tdorssers/Robot/schematic/Robot.sch

## EAGLE design schematic/Robot.sch (2018-08-26)

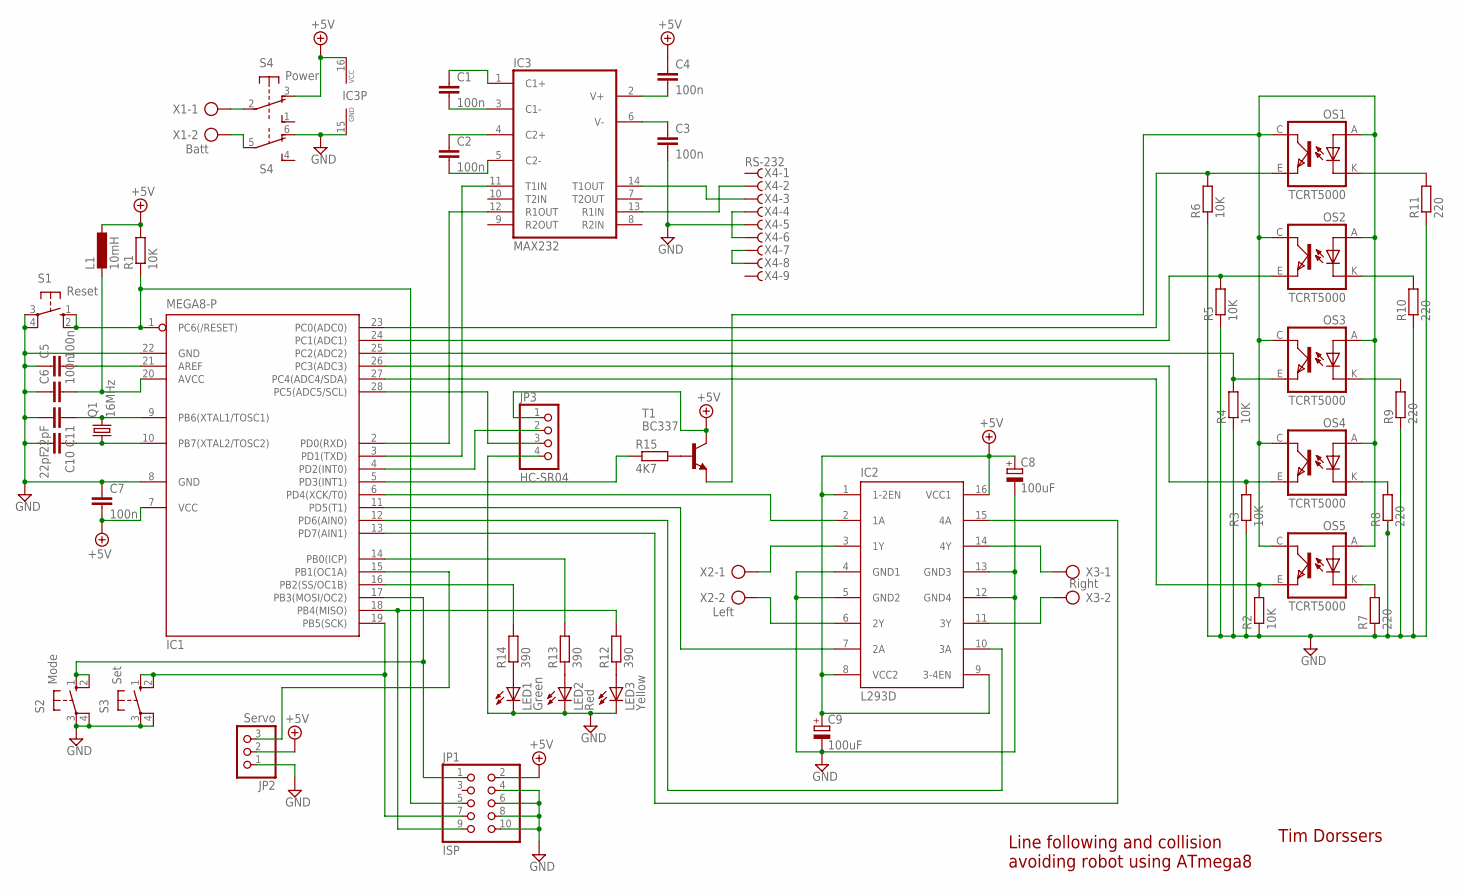
[picture p3: schematic Robot.sch]

Parts:
C1, C2, C3, C4, C5, C6, C7: 100n; C025-025X050
C8, C9: 100uF; B45181A
C10, C11: 22pF; C025-024X044
IC1: MEGA8-P; DIL28-3
IC2: L293D; DIL16
IC3: MAX232; DIL16
JP1: ISP; 2X05
JP2: Servo; 1X03
JP3: HC-SR04; 1X04
L1: 10mH; 0207/10
LED1: Green; LED5MM
LED2: Red; LED5MM
LED3: Yellow; LED5MM
OS1, OS2, OS3, OS4, OS5: TCRT5000
Q1: 16MHz; HC49U-V
R1, R2, R3, R4, R5, R6: 10K; 0204/7
R7, R8, R9, R10, R11: 220; 0204/7
R12, R13, R14: 390; 0204/7
R15: 4K7; 0204/7
S1: Reset; B3F-10XX
S2: Mode; B3F-10XX
S3: Set; B3F-10XX
S4: Power; PVA2F
T1: BC337; TO92
X1: Batt; AK300/2
X2: Left; AK300/2
X3: Right; AK300/2
X4: RS-232; H3M09RA

Connections:
+5V: C4.1, C7.2, C8.+, C9.+, IC1.7 (VCC), IC2.1 (1-2EN), IC2.8 (VCC2), IC2.9 (3-4EN), IC2.16 (VCC1), IC3.16 (VCC), JP1.2, JP2.2, JP3.1, L1.1, R1.2, S4.3 (O), T1.3 (C)
GND: C3.2, C5.1, C6.1, C7.1, C8.-, C9.-, C10.2, C11.2, IC1.8 (GND), IC1.22 (GND), IC2.4 (GND1), IC2.5 (GND2), IC2.12 (GND4), IC2.13 (GND3), IC3.15 (GND), JP1.4, JP1.6, JP1.8, JP1.10, JP2.1, JP3.4, LED1.K (C), LED2.K (C), LED3.K (C), R2.1, R3.1, R4.1, R5.1, R6.1, R7.1, R8.1, R9.1, R10.1, R11.1, S1.3, S1.4 (P1), S2.3, S2.4 (P1), S3.3, S3.4 (P1), S4.6 (O), X4.5
unnamed: LED3.A, R12.1
unnamed: IC1.23 (PC0(ADC0)), OS1.E (EMITTER), R6.2
unnamed: IC1.24 (PC1(ADC1)), OS2.E (EMITTER), R5.2
unnamed: IC1.25 (PC2(ADC2)), OS3.E (EMITTER), R4.2
unnamed: IC1.26 (PC3(ADC3)), OS4.E (EMITTER), R3.2
unnamed: IC1.27 (PC4(ADC4/SDA)), OS5.E (EMITTER), R2.2
unnamed: OS5.K (CATHODE), R7.2
unnamed: OS1.K (CATHODE), R11.2
unnamed: OS2.K (CATHODE), R10.2
unnamed: OS3.K (CATHODE), R9.2
unnamed: OS4.K (CATHODE), R8.2
unnamed: S4.5, X1.2
unnamed: C4.2, IC3.2 (V+)
unnamed: C3.1, IC3.6 (V-)
unnamed: C1.1, IC3.1 (C1+)
unnamed: C1.2, IC3.3 (C1-)
unnamed: C2.1, IC3.4 (C2+)
unnamed: C2.2, IC3.5 (C2-)
unnamed: IC1.1 (PC6(/RESET)), JP1.5, R1.1, S1.1 (S), S1.2 (S1)
unnamed: C11.1, IC1.9 (PB6(XTAL1/TOSC1)), Q1.2
unnamed: C10.1, IC1.10 (PB7(XTAL2/TOSC2)), Q1.1
unnamed: C5.2, IC1.21 (AREF)
unnamed: C6.2, IC1.20 (AVCC), L1.2
unnamed: S4.2, X1.1
unnamed: IC1.2 (PD0(RXD)), IC3.12 (R1OUT)
unnamed: IC1.3 (PD1(TXD)), IC3.11 (T1IN)
unnamed: IC1.4 (PD2(INT0)), JP3.2
unnamed: IC1.6 (PD4(XCK/T0)), IC2.2 (1A)
unnamed: IC1.11 (PD5(T1)), IC2.7 (2A)
unnamed: IC1.12 (PD6(AIN0)), IC2.10 (3A)
unnamed: IC2.3 (1Y), X2.1
unnamed: IC2.6 (2Y), X2.2
unnamed: IC2.14 (4Y), X3.1
unnamed: IC2.11 (3Y), X3.2
unnamed: IC1.13 (PD7(AIN1)), IC2.15 (4A)
unnamed: IC1.28 (PC5(ADC5/SCL)), JP3.3
unnamed: LED1.A, R14.1
unnamed: IC1.15 (PB1(OC1A)), JP2.3
unnamed: X4.7, X4.8
unnamed: X4.4, X4.6
unnamed: IC3.13 (R1IN), X4.2
unnamed: IC3.14 (T1OUT), X4.3
unnamed: LED2.A, R13.1
unnamed: IC1.17 (PB3(MOSI/OC2)), JP1.1, S2.1 (S), S2.2 (S1)
unnamed: IC1.5 (PD3(INT1)), R15.1
unnamed: IC1.16 (PB2(SS/OC1B)), R14.2
unnamed: IC1.14 (PB0(ICP)), R13.2
unnamed: R15.2, T1.2 (B)
unnamed: OS1.A (ANODE), OS1.C (COLLECTOR), OS2.A (ANODE), OS2.C (COLLECTOR), OS3.A (ANODE), OS3.C (COLLECTOR), OS4.A (ANODE), OS4.C (COLLECTOR), OS5.A (ANODE), OS5.C (COLLECTOR), T1.1 (E)
unnamed: IC1.19 (PB5(SCK)), JP1.7, S3.1 (S), S3.2 (S1)
unnamed: IC1.18 (PB4(MISO)), JP1.9, R12.2

Notes on the sheet:
Tim Dorssers
Line following and collision avoiding robot using ATmega8
